pgupta9204/solar-telemetry/solar-airtag-kicad/solar-airtag-kicad.kicad_pcb

## KiCad design solar-airtag-kicad/solar-airtag-kicad.kicad_pcb (2026-10-11)

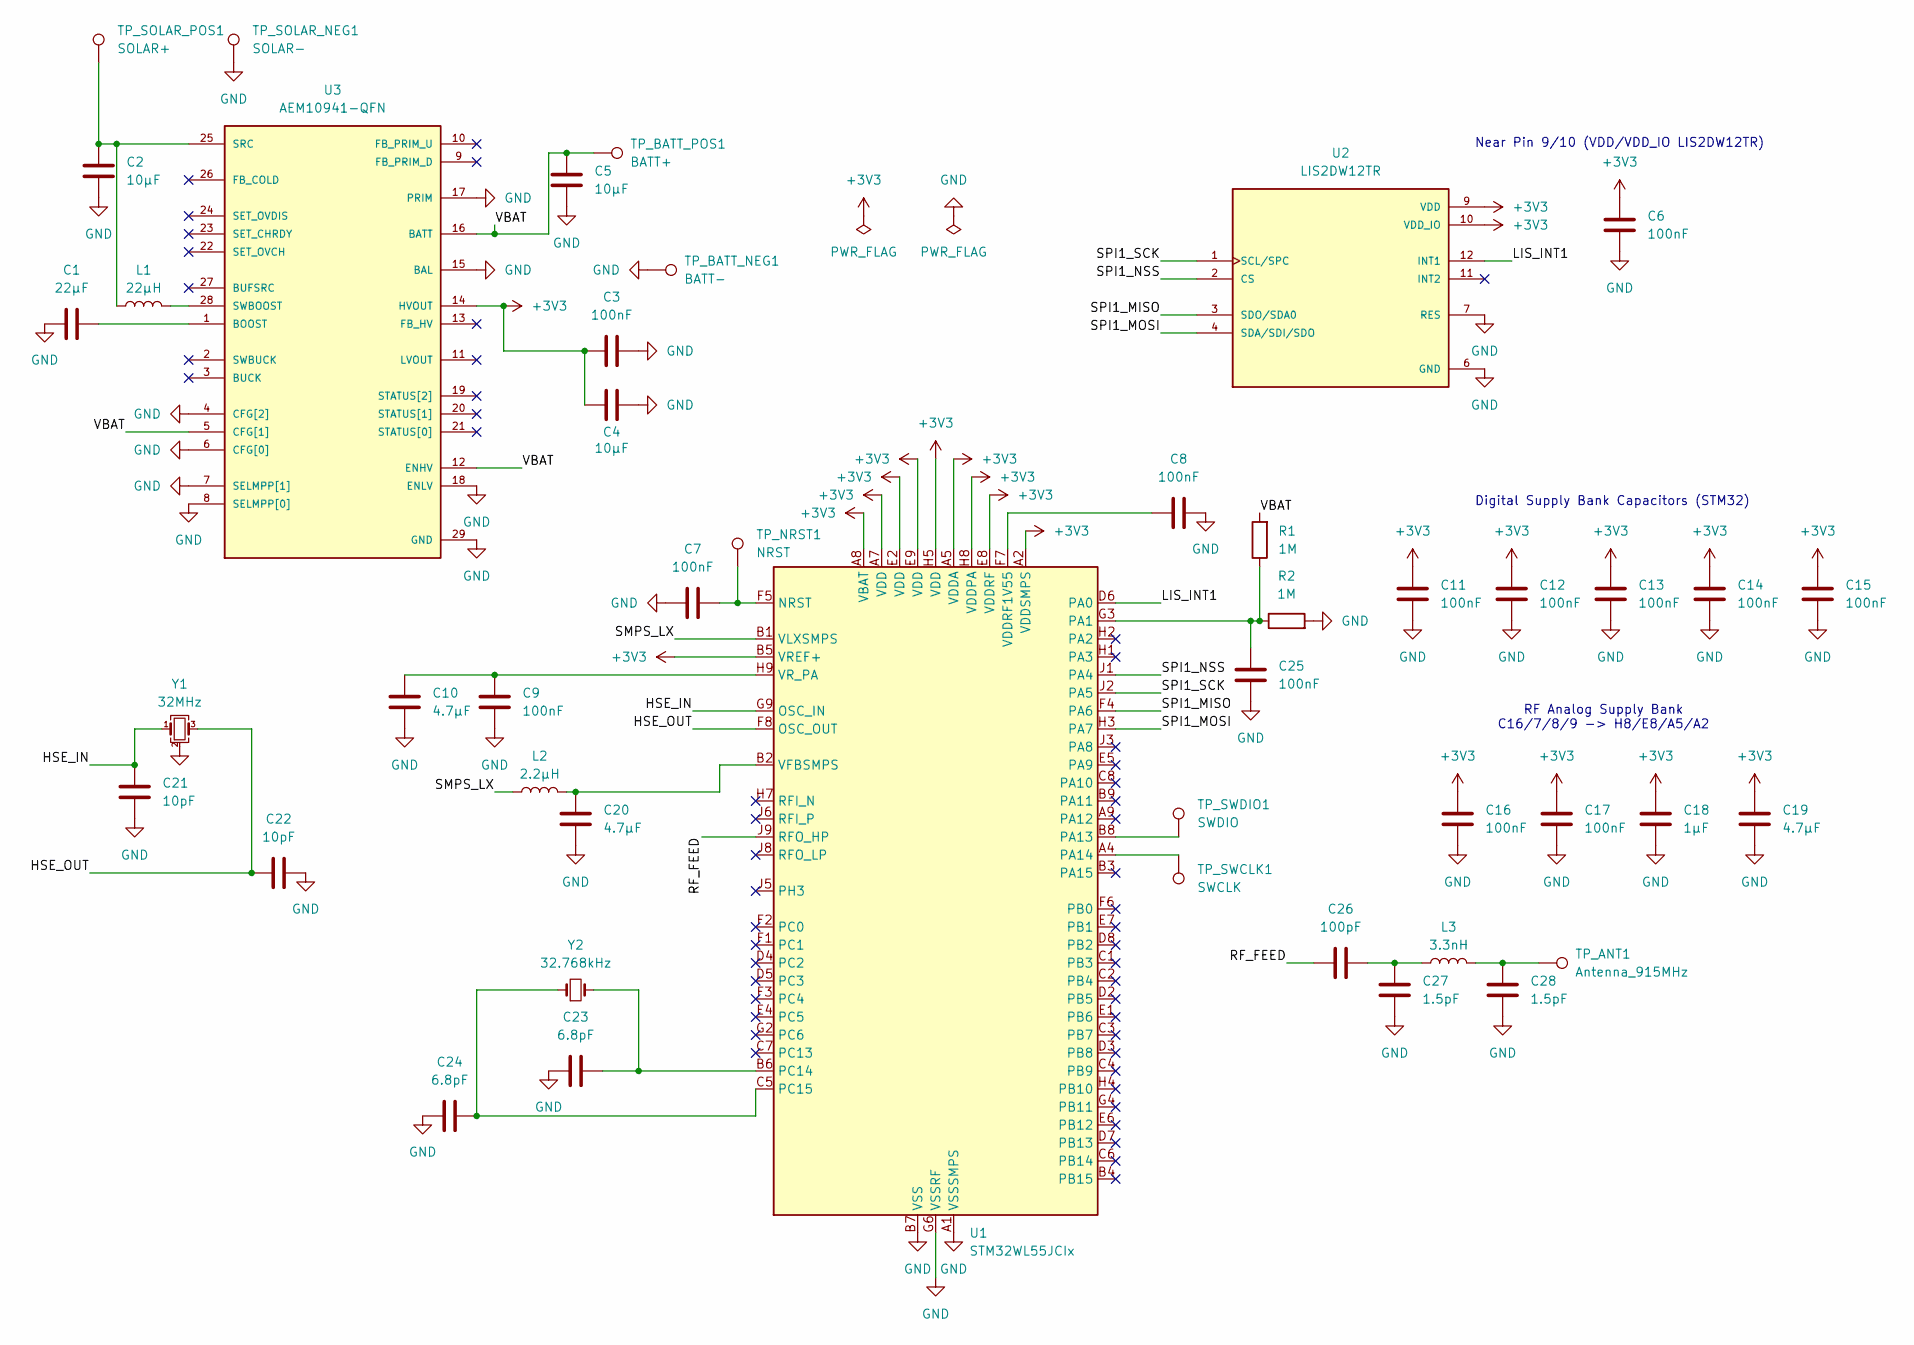
[picture p1: schematic solar-airtag-kicad.kicad_sch]

Parts:
C1: 22µF; C_0805_2012Metric
C2, C4, C5: 10µF; C_0603_1608Metric
C3, C6, C7, C8, C9, C11, C12, C13, C14, C15, C16, C17, C25: 100nF; C_0402_1005Metric
C10, C19, C20: 4.7µF; C_0603_1608Metric
C18: 1µF; C_0402_1005Metric
C21, C22: 10pF; C_0402_1005Metric
C23, C24: 6.8pF; C_0402_1005Metric
C26: 100pF; C_0402_1005Metric
C27, C28: 1.5pF; C_0402_1005Metric
L1: 22µH; L_0805_2012Metric
L2: 2.2µH; L_0805_2012Metric
L3: 3.3nH; L_0402_1005Metric
R1, R2: 1M; R_0402_1005Metric
TP_ANT1: Antenna_915MHz; TestPoint_Pad_D1.5mm
TP_BATT_NEG1: BATT-; TestPoint_Pad_D1.5mm
TP_BATT_POS1: BATT+; TestPoint_Pad_D1.5mm
TP_NRST1: NRST; TestPoint_Pad_D1.0mm
TP_SOLAR_NEG1: SOLAR-; TestPoint_Pad_D1.5mm
TP_SOLAR_POS1: SOLAR+; TestPoint_Pad_D1.5mm
TP_SWCLK1: SWCLK; TestPoint_Pad_D1.0mm
TP_SWDIO1: SWDIO; TestPoint_Pad_D1.0mm
U1: STM32WL55JCIx; ST_UFBGA-73_5x5mm_Layout9x9_P0.5mm
U2: LIS2DW12TR; LGA12R50P4X4_200X200X70; PARTREV 4
U3: AEM10941-QFN; QFN50P500X500X90-29N; PARTREV 1.4
Y1: 32MHz; Crystal_SMD_3225-4Pin_3.2x2.5mm
Y2: 32.768kHz; Crystal_SMD_3215-2Pin_3.2x1.5mm

Connections:
+3V3: C3.1, C4.1, C6.1, C11.1, C12.1, C13.1, C14.1, C15.1, C16.1, C17.1, C18.1, C19.1, U1.A2 (VDDSMPS), U1.A5 (VDDA), U1.A7 (VDD), U1.A8 (VBAT), U1.B5 (VREF+), U1.E2 (VDD), U1.E8 (VDDRF), U1.E9 (VDD), U1.H5 (VDD), U1.H8 (VDDPA), U2.9 (VDD), U2.10 (VDD_IO), U3.14 (HVOUT)
/HSE_IN: C21.1, U1.G9 (OSC_IN), Y1.1
/HSE_OUT: C22.1, U1.F8 (OSC_OUT), Y1.3
/LIS_INT1: U1.D6 (PA0), U2.12 (INT1)
/RF_FEED: C26.1, U1.J9 (RFO_HP)
/SMPS_LX: L2.1, U1.B1 (VLXSMPS)
/SPI1_MISO: U1.F4 (PA6), U2.3 (SDO/SDA0)
/SPI1_MOSI: U1.H3 (PA7), U2.4 (SDA/SDI/SDO)
/SPI1_NSS: U1.J1 (PA4), U2.2 (CS)
/SPI1_SCK: U1.J2 (PA5), U2.1 (SCL/SPC)
/VBAT: C5.1, R1.2, TP_BATT_POS1.1 (1_1), U3.5 (CFG[1]), U3.12 (ENHV), U3.16 (BATT)
GND: C1.1, C2.2, C3.2, C4.2, C5.2, C6.2, C7.1, C8.1, C9.2, C10.1, C11.2, C12.2, C13.2, C14.2, C15.2, C16.2, C17.2, C18.2, C19.2, C20.2, C21.2, C22.2, C23.1, C24.1, C25.2, C27.2, C28.2, R2.2, TP_BATT_NEG1.1 (1_1), TP_SOLAR_NEG1.1 (1_1), U1.A1 (VSSSMPS), U1.B7 (VSS), U1.D9 (VSS), U1.E3 (VSS), U1.G5 (VSS), U1.G6 (VSSRF), U1.G7 (VSSRF), U1.G8 (VSSRF), U1.H6 (VSSRF), U2.6 (GND), U2.7 (RES), U2.8 (GND), U3.4 (CFG[2]), U3.6 (CFG[0]), U3.7 (SELMPP[1]), U3.8 (SELMPP[0]), U3.15 (BAL), U3.17 (PRIM), U3.18 (ENLV), U3.29 (GND), Y1.2 (G), Y1.4 (G)
unnamed: C26.2, C27.1, L3.1
unnamed: C28.1, L3.2, TP_ANT1.1 (1_1)
unnamed: C7.2, TP_NRST1.1 (1_1), U1.F5 (NRST)
unnamed: C25.1, R1.1, R2.1, U1.G3 (PA1)
unnamed: TP_SWDIO1.1 (1_1), U1.B8 (PA13)
unnamed: TP_SWCLK1.1 (1_1), U1.A4 (PA14)
unnamed: C23.2, U1.B6 (PC14), Y2.2
unnamed: C24.2, U1.C5 (PC15), Y2.1
unnamed: C8.2, U1.F7 (VDDRF1V55)
unnamed: C20.1, L2.2, U1.B2 (VFBSMPS)
unnamed: C9.1, C10.2, U1.H9 (VR_PA)
unnamed: C1.2, U3.1 (BOOST)
unnamed: C2.1, L1.1, TP_SOLAR_POS1.1 (1_1), U3.25 (SRC)
unnamed: L1.2, U3.28 (SWBOOST)

Notes on the sheet:
RF Analog Supply Bank C16/7/8/9 -> H8/E8/A5/A2
Digital Supply Bank Capacitors (STM32)
Near Pin 9/10 (VDD/VDD_IO LIS2DW12TR)

Board: 4 copper layers, 46 parts (0 on the bottom side), 26 nets, no tracks yet.
